dzelenka/CreeRelays/(commit log)

2017-01-24 Update CreeRelays.ino
    Wildly simplified version of the code. I've tested it for quite a while and found it nice and stable.
    Simplified the interrupt routine to calculate the PWM value.
2017-01-24 Update CreeRelays.device.groovy
    This is just about the most basic of device drivers. It allow me to create a virtual button for each of my garage doors. I'll create a smartapp to take the events from these virtual buttons send commands to the Cree Bulb device.
2017-02-04 Update CreeRelays.ino
    Implemented improvements to allow 8 independent relays.
    Allow the actions "off", "on", "toggle", "pulse".
    Improved variable names.
    Added a timing loop to get rid of most of the delay statements.
